tudsat-rocket/gse_connector_board/gse_connector_board_inner/production/bom.csv

Designator | Footprint | Quantity | Value | LCSC Part #
D1 | SOT-23 | 1 | PESD2CAN | C75176
R1 | 0402 | 1 | 120 | C25079
