tudsat-rocket/gse_connector_board/gse_connector_board_inner/3d-models/STP_463092691402 (rev1).stp

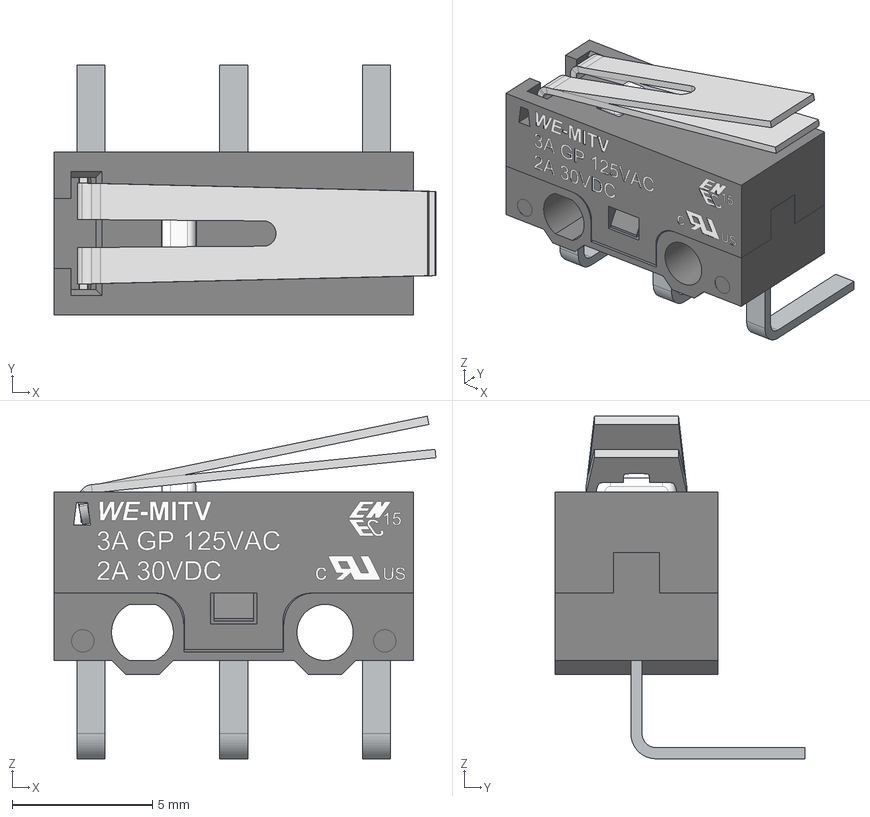
[picture p1: CAD file, 2026-09-08]
gse_connector_board_inner/3d-models/STP_463092691402 (rev1).stp
13.6 x 8.90 x 12.2 mm
Base
Terminal x 3
Straight_lever x 2
Button x 2
Cover
