tudsat-rocket/gse_connector_board/gse_connector_board_inner/custom_parts/Magnetic_Connectors_Umbilical_Outer.stp

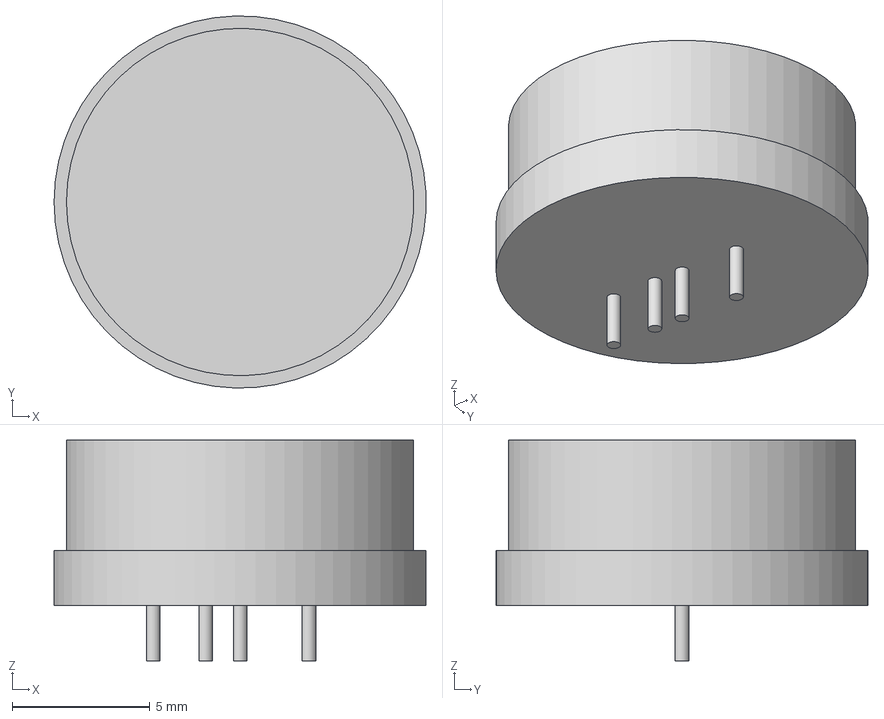
[picture p2: CAD file, 2026-07-01]
gse_connector_board_inner/custom_parts/Magnetic_Connectors_Umbilical_Outer.stp
13.5 x 13.5 x 8.00 mm
