tudsat-rocket/gse_connector_board/gse_connector_board_inner/gse_connector_board_inner.step

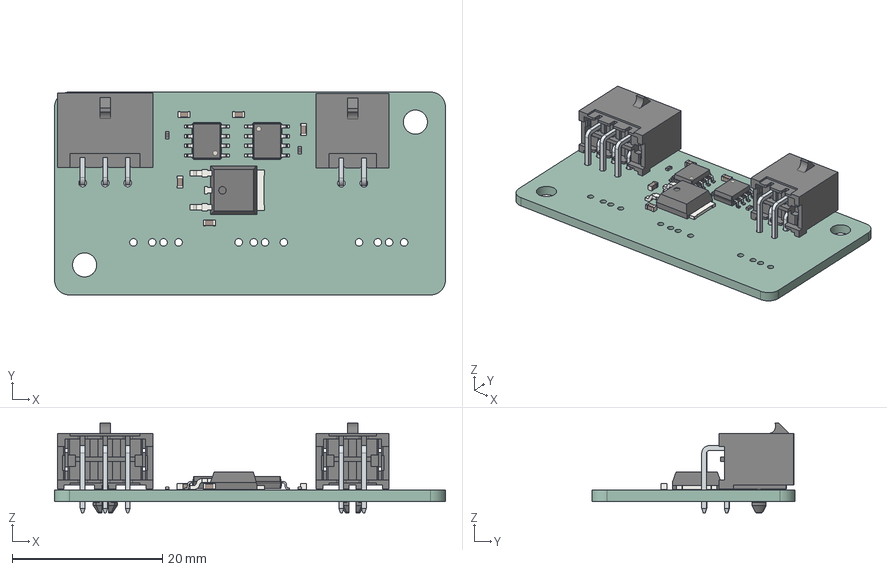
[picture p3: CAD file, 2026-09-08]
gse_connector_board_inner/gse_connector_board_inner.step
52.0 x 27.0 x 12.0 mm
C_0603_1608Metric x 5
SOIC-8_3.9x4.9mm_P1.27mm x 2
6620xx21022_PIN_COURTE x 5
6620xx21022_PIN_LONGUE x 5
R_0402_1005Metric x 2
932d09b3-9c39-11ed-93f0-dde97e994e83_part
932d09b4-9c39-11ed-93f0-dde97e994e83_part
932d09b5-9c39-11ed-93f0-dde97e994e83_part
gse_connector_board_PCB
