tudsat-rocket/gse_connector_board/gse_connector_board_outer/gse_connector_board_outer.step

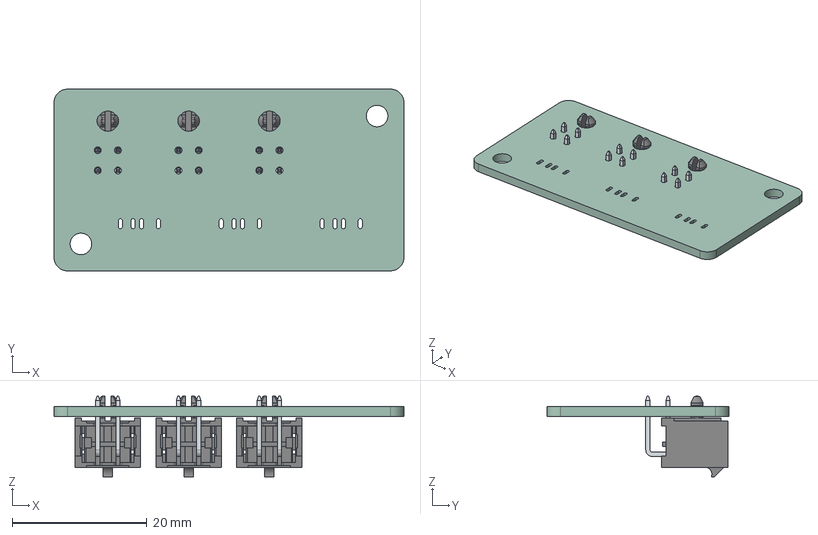
[picture p4: CAD file, 2026-09-08]
gse_connector_board_outer/gse_connector_board_outer.step
52.0 x 27.0 x 12.0 mm
6620xx21022_PIN_COURTE x 6
6620xx21022_PIN_LONGUE x 6
gse_connector_board_outer_PCB
