tudsat-rocket/gse_connector_board/gse_connector_board_inner/gse_connector_board_innner.stl

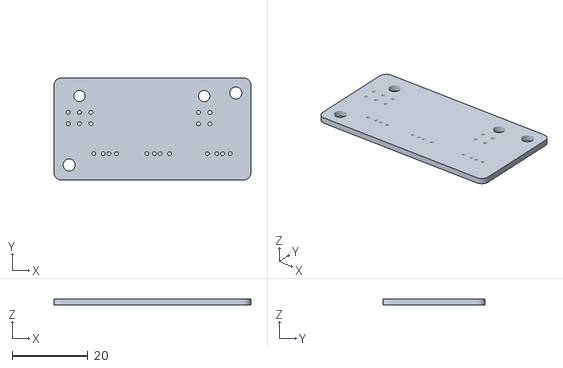
[picture p5: CAD file, 2026-09-08]
gse_connector_board_inner/gse_connector_board_innner.stl
52.0 x 27.0 x 1.51
