tudsat-rocket/gse_connector_board/gse_connector_board_outer/3d-models/66200621022 (rev1).stp

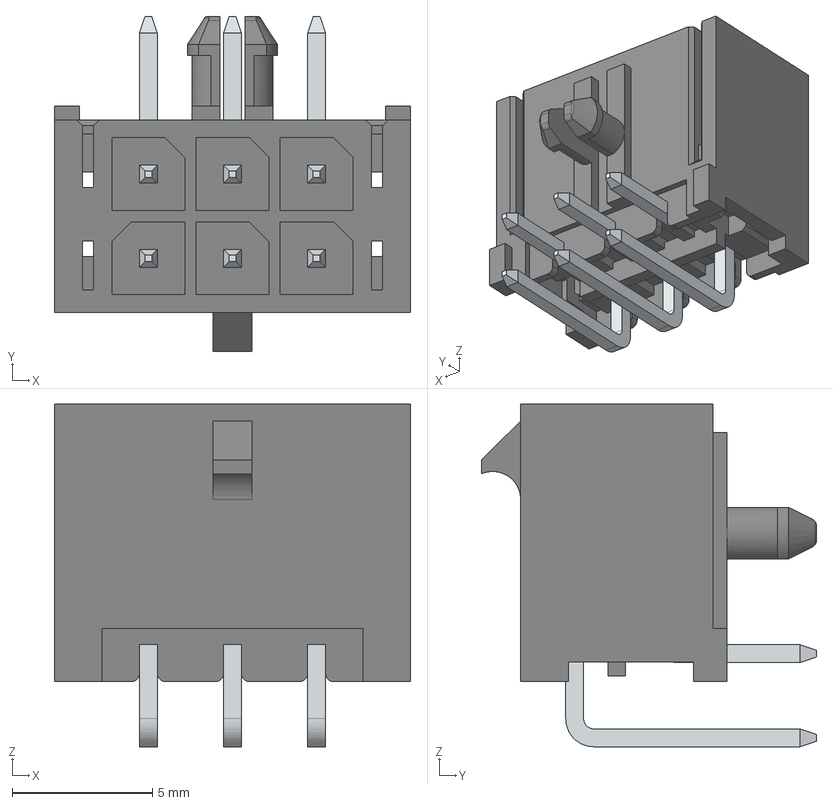
[picture p7: CAD file, 2026-09-08]
gse_connector_board_outer/3d-models/66200621022 (rev1).stp
12.7 x 12.0 x 12.2 mm
6620xx21022_PIN_COURTE x 3
6620xx21022_PIN_LONGUE x 3
