tudsat-rocket/gse_connector_board/(list of files, cad)

Other CAD files:
gse_connector_board_inner/3d-models/66200621024_STP (rev1).stp
gse_connector_board_outer/3d-models/66200421024_STP (rev1).stp
gse_connector_board_inner/3d-models/66200421024_STP (rev1).stp
gse_connector_board_outer/gse_connector_board_outer.stl
