tudsat-rocket/gse_connector_board/gse_connector_board_inner/gse_connector_board.kicad_pcb

## KiCad design gse_connector_board_inner/gse_connector_board.kicad_pcb (2026-09-10)

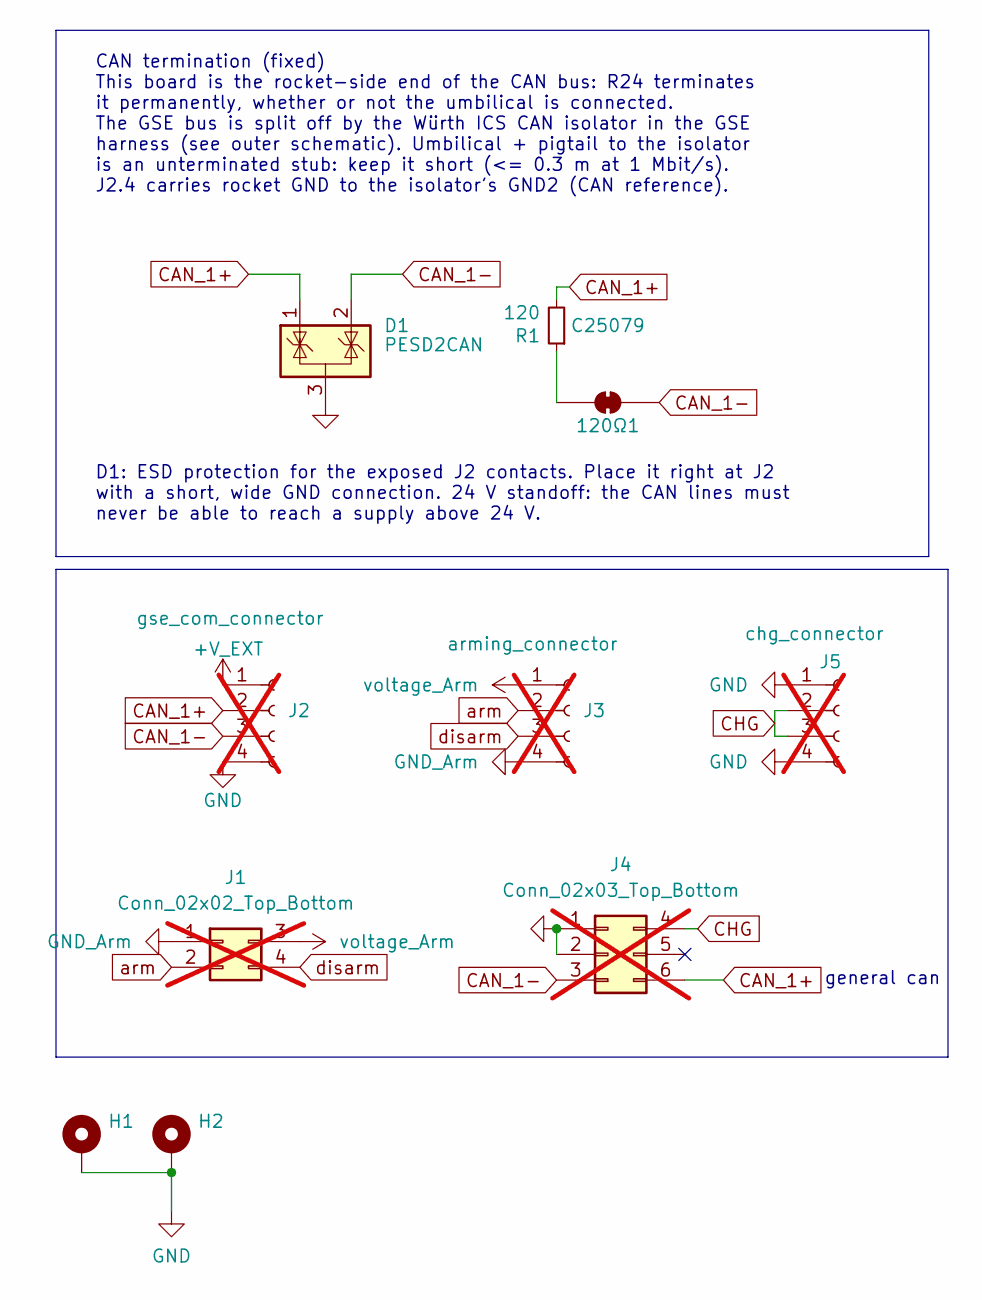
[picture p8: schematic gse_connector_board.kicad_sch]

Parts:
120Ω1: SolderJumper_2_Bridged; SolderJumper-2_P1.3mm_Bridged_RoundedPad1.0x1.5mm
D1: PESD2CAN; SOT-23; Part# PESD2CAN,215; LCSC C75176
H1, H2: MountingHole_Pad; MountingHole_3.2mm_M3_DIN965_Pad
J1: Conn_02x02_Top_Bottom; Molex_Micro-Fit_3.0_43045-0400_2x02_P3.00mm_Horizontal; not fitted
J2: gse_com_connector; 4_pin_mag_con_mv_adapt; not fitted
J3: arming_connector; 4_pin_mag_con_mv_adapt; not fitted
J4: Conn_02x03_Top_Bottom; Molex_Micro-Fit_3.0_43045-0600_2x03_P3.00mm_Horizontal; not fitted
J5: chg_connector; 4_pin_mag_con_mv_adapt; not fitted
R1: 120; R_0402_1005Metric; LCSC C25079

Connections:
+V_EXT: J2.1
CAN_1+: D1.1 (K), J2.2, J4.6, R1.2
CAN_1-: 120Ω1.2 (B), D1.2 (K), J2.3, J4.3
CHG: J4.4, J5.2, J5.3
GND: D1.3 (A), H1.1 (1_1), H2.1 (1_1), J2.4, J4.1, J4.2, J5.1, J5.4
GND_Arm: J1.1, J3.4
unnamed: 120Ω1.1 (A), R1.1
arm: J1.2, J3.2
disarm: J1.4, J3.3
voltage_Arm: J1.3, J3.1

Notes on the sheet:
D1: ESD protection for the exposed J2 contacts. Place it right at J2 with a short, wide GND connection. 24 V standoff: the CAN lines must never be able to reach a supply above 24 V.
general can
CAN termination (fixed) This board is the rocket-side end of the CAN bus: R24 terminates it permanently, whether or not the umbilical is connected. The GSE bus is split off by the Würth ICS CAN isolator in the GSE harness (see outer schematic). Umbilical + pigtail to the isolator is an unterminated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

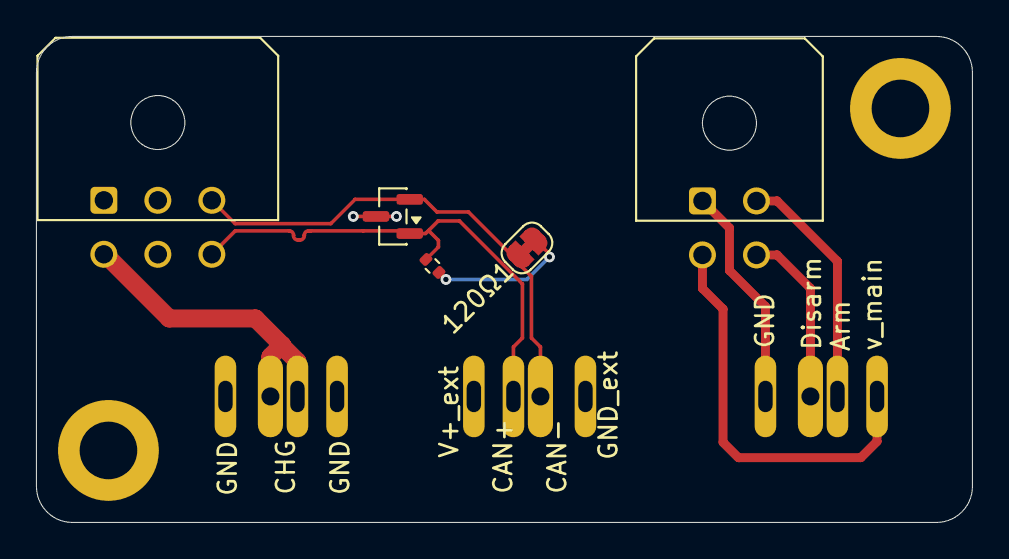
[picture p9: board gse_connector_board.kicad_pcb from above]

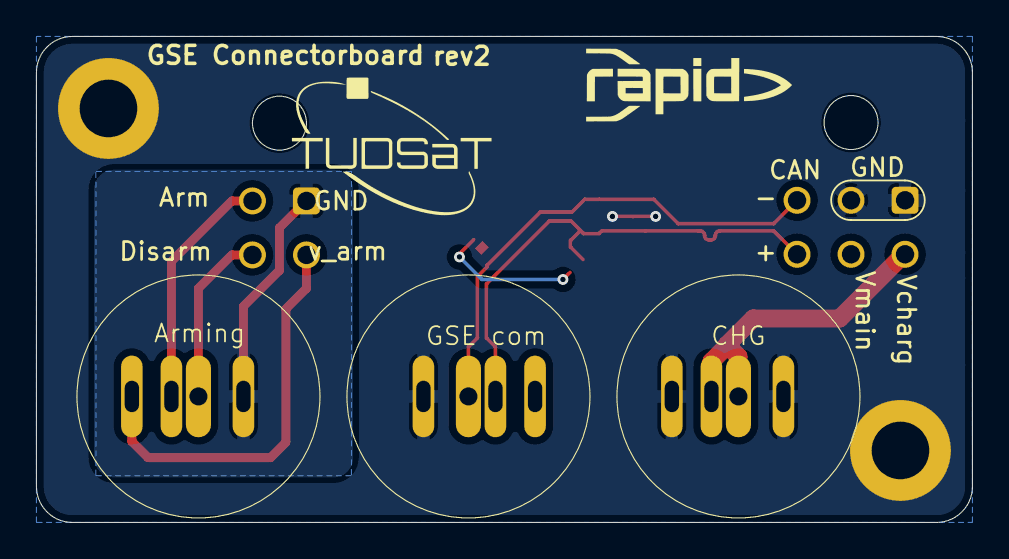
[picture p10: board gse_connector_board.kicad_pcb from below]

Board: 2 copper layers, 52.0 x 27.0 mm, 10 parts (3 on the bottom side), 9 nets.
