tudsat-rocket/gse_connector_board/gse_connector_board_outer/gse_connector_board_outer.kicad_pcb

## KiCad design gse_connector_board_outer/gse_connector_board_outer.kicad_pcb (2026-09-10)

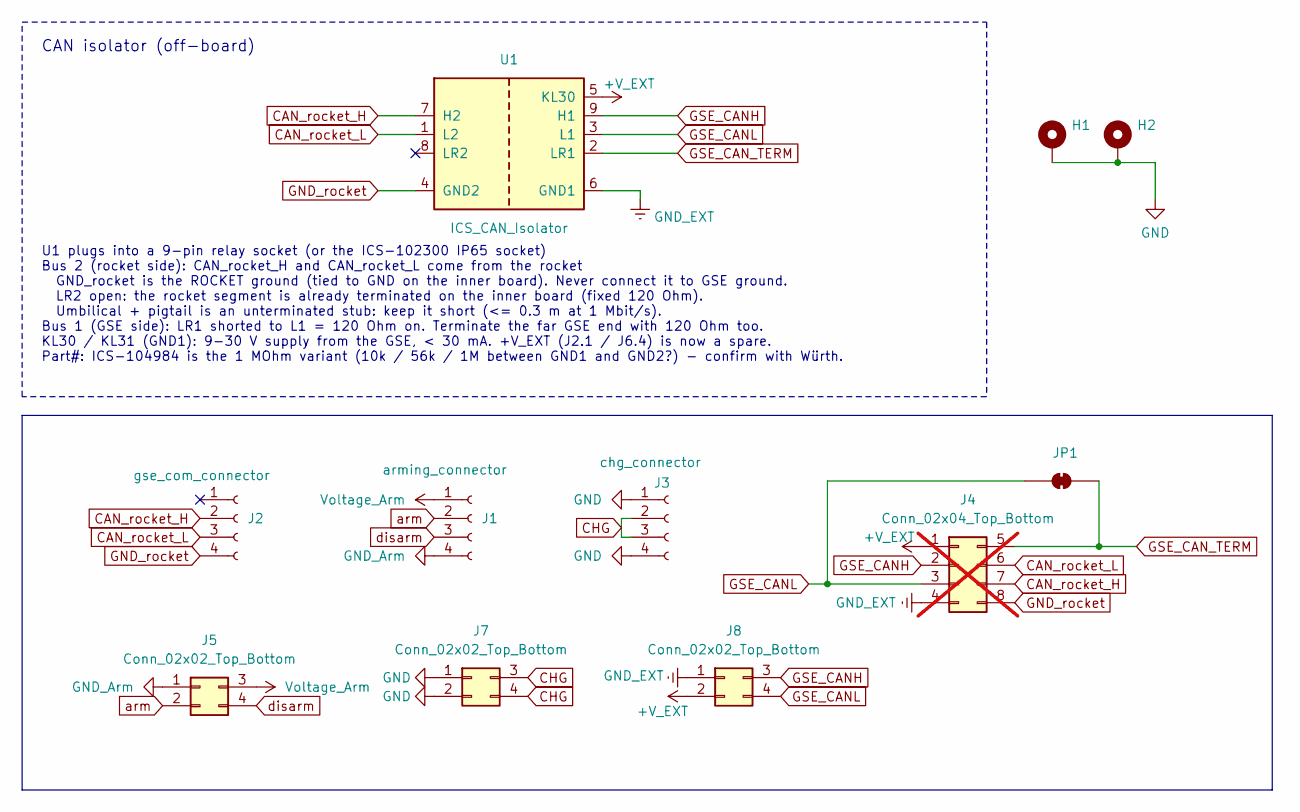
[picture p11: schematic gse_connector_board_outer.kicad_sch]

Parts:
H1, H2: MountingHole_Pad; MountingHole_3.2mm_M3_DIN965_Pad
J1: arming_connector; 4_pin_mag_con_flat_mv_adapt
J2: gse_com_connector; 4_pin_mag_con_flat_mv_adapt
J3: chg_connector; 4_pin_mag_con_flat_mv_adapt
J4: Conn_02x04_Top_Bottom; Molex_Micro-Fit_3.0_43045-0800_2x04_P3.00mm_Horizontal; not fitted
J5, J7, J8: Conn_02x02_Top_Bottom; Molex_Micro-Fit_3.0_43045-0400_2x02_P3.00mm_Horizontal
JP1: SolderJumper_2_Bridged; SolderJumper-2_P1.3mm_Bridged_RoundedPad1.0x1.5mm
U1: ICS_CAN_Isolator; Part# ICS-104984

Connections:
+V_EXT: J4.1, J8.2, U1.5 (KL30)
CAN_rocket_H: J2.2, J4.7, U1.7 (H2)
CAN_rocket_L: J2.3, J4.6, U1.1 (L2)
CHG: J3.2, J3.3, J7.3, J7.4
GND: H1.1 (1_1), H2.1 (1_1), J3.1, J3.4, J7.1, J7.2
GND_Arm: J1.4, J5.1
GND_EXT: J4.4, J8.1, U1.6 (GND1)
GND_rocket: J2.4, J4.8, U1.4 (GND2)
GSE_CANH: J4.2, J8.3, U1.9 (H1)
GSE_CANL: J4.3, J8.4, JP1.2 (B), U1.3 (L1)
GSE_CAN_TERM: J4.5, JP1.1 (A), U1.2 (LR1)
Voltage_Arm: J1.1, J5.3
arm: J1.2, J5.2
disarm: J1.3, J5.4

Notes on the sheet:
U1 plugs into a 9-pin relay socket (or the ICS-102300 IP65 socket) Bus 2 (rocket side): CAN_rocket_H and CAN_rocket_L come from the rocket GND_rocket is the ROCKET ground (tied to GND on the inner board). Never connect it to GSE ground. LR2 open: the rocket segment is already terminated on the inne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
CAN isolator (off-board)

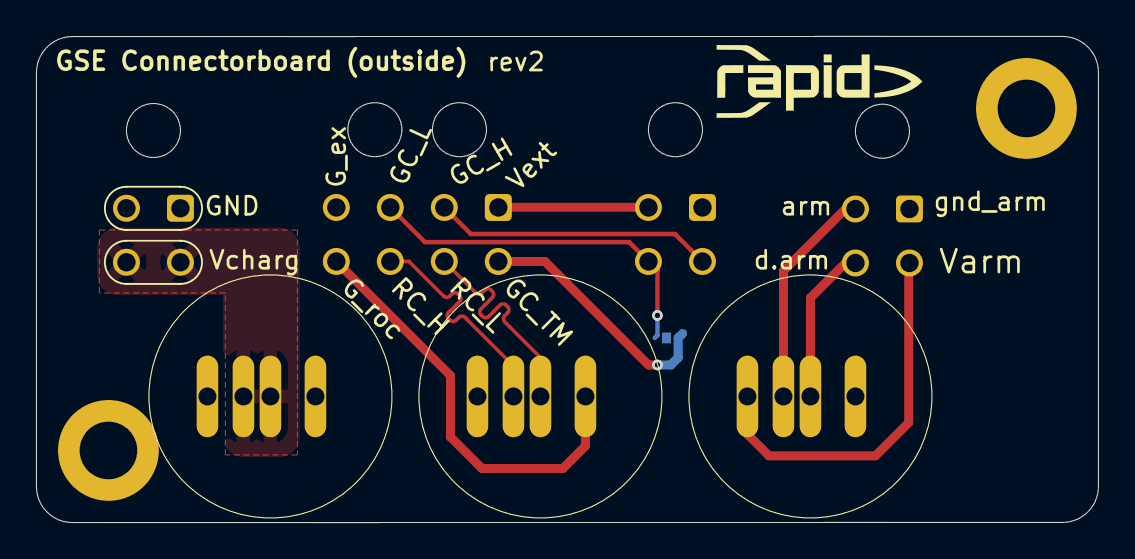
[picture p12: board gse_connector_board_outer.kicad_pcb from above]

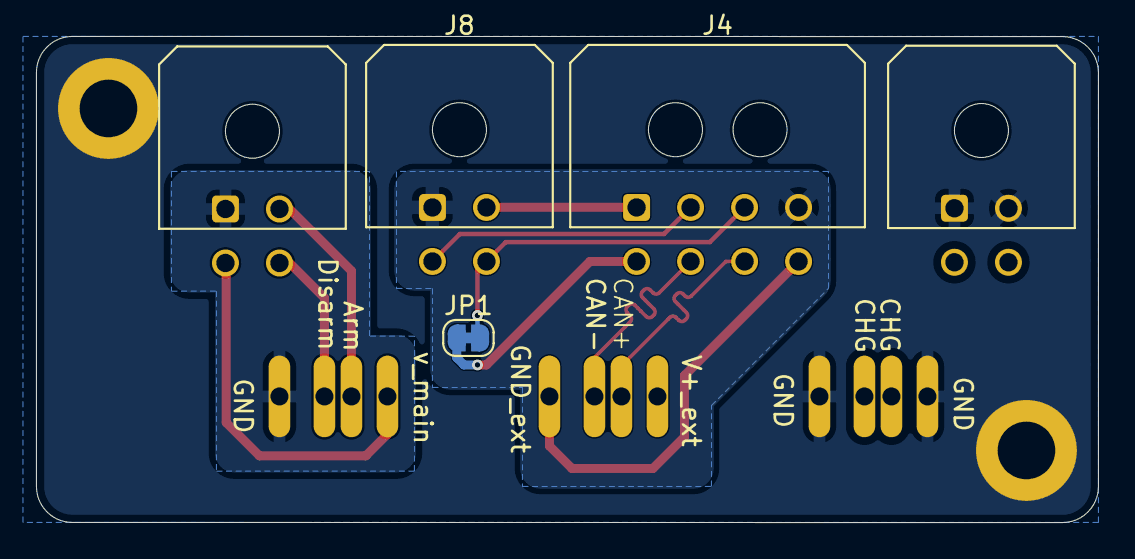
[picture p13: board gse_connector_board_outer.kicad_pcb from below]

Board: 2 copper layers, 59.0 x 27.0 mm, 10 parts (5 on the bottom side), 14 nets.
