tudsat-rocket/gse_connector_board/(commit log)

2026-06-22 Add files via upload
    changed footprint of agnetic connector, finished routing and layout of connector board
    [gse_connector_board.kicad_pcb, gse_connector_board.kicad_sch]
2026-06-23 Add files via upload
    added rounded corners
    [gse_connector_board.kicad_pcb]
2026-06-24 Add files via upload
    Added Silkscreen and Testpoints for CAN
    [gse_connector_board.kicad_pcb, gse_connector_board.kicad_sch]
2026-06-24 Add files via upload
    excluded Molex connectors from BOM and put in DNP.
    added Testpoints for 5V, main voltage and Charging
    [gse_connector_board.kicad_pcb, gse_connector_board.kicad_sch]
2026-06-24 Add files via upload
    changed silkscreen
    [gse_connector_board.kicad_pcb]
2026-06-24 Add files via upload
    added the outsidepart of the connector
    [gse_connector_board_outer.kicad_pcb, gse_connector_board_outer.kicad_sch]
2026-06-25 final silkscreen improvements and small fixes
    [gse_connector_board.kicad_pcb, gse_connector_board.kicad_sch]
2026-06-27 fix silkscreen
    [gse_connector_board_outer.kicad_pcb]
2026-06-28 edited grounding and edge cuts
    [bom.csv, designators.csv, gse_connector_board.kicad_pcb, gse_connector_board_outer.kicad_pcb, positions.csv]
2026-06-29 order version
    [rapid_power_module.step]
2026-07-01 cleanup and export 3d-models
    [66200421024_STP (rev1).stp, 66200621024_STP (rev1).stp, Magnetic_Connectors_Umbilical_Outer.stp, bom.csv, designators.csv, gse_connector_board.kicad_pcb, gse_connector_board.kicad_sch, gse_connector_board_inner.kicad_pcb]
2026-08-03 fixed magnetic connector footprint
    made the holes in the magnetic connectors wider
2026-08-26 changed the footprints of the magnetic connector and routing of inner board
    [bom.csv, designators.csv, gse_connector_board.kicad_pcb, gse_connector_board.kicad_sch, gse_connector_board_inner.kicad_pcb, gse_connector_board_inner.step, gse_connector_board_inner.stl, gse_connector_board_outer.kicad_pcb]
2026-09-05 adapted footprints, scematics and routing
    [gse_connector_board.kicad_pcb, gse_connector_board.kicad_sch, gse_connector_board_outer.kicad_pcb]
2026-09-07 implemented changes
    [gse_connector_board.kicad_pcb, gse_connector_board.kicad_sch, gse_connector_board_outer.kicad_pcb, gse_connector_board_outer.kicad_sch]
2026-09-08 added 3d models
    [66200421022 (rev1).stp, 66200621022 (rev1).stp, STP_463092691402 (rev1).stp, gse_connector_board_inner.step, gse_connector_board_innner.stl, gse_connector_board_outer.kicad_pcb, gse_connector_board_outer.step, gse_connector_board_outer.stl]
2026-09-09 cleanup silkscreen
    [gse_connector_board.kicad_pcb, gse_connector_board_outer.kicad_pcb, gse_connector_board_outer.kicad_sch]
2026-09-09 fix connector pinout
    [gse_connector_board_outer.kicad_pcb, gse_connector_board_outer.kicad_sch]
2026-09-09 replace can isolation with mosfet
    [gse_connector_board.kicad_pcb, gse_connector_board.kicad_sch]
2026-09-10 replace can isolation with würth part
    [gse_connector_board.kicad_sch, gse_connector_board_outer.kicad_sch]
2026-09-10 add esd protection
    [gse_connector_board.kicad_sch]
2026-09-10 route new can isolation
    [gse_connector_board.kicad_pcb, gse_connector_board.kicad_sch, gse_connector_board_outer.kicad_pcb, gse_connector_board_outer.kicad_sch]
2026-09-10 adapted footprint again
    [gse_connector_board.kicad_pcb, gse_connector_board.kicad_sch, gse_connector_board_outer.kicad_pcb, gse_connector_board_outer.kicad_sch]
2026-09-10 final order version
    [bom.csv, designators.csv, gse_connector_board.kicad_pcb, gse_connector_board.kicad_sch, gse_connector_board_outer.kicad_pcb, gse_connector_board_outer.kicad_sch, positions.csv]
